ciprian1234/licenta_cnc/docs/poze/asamblare_hardware.jpg

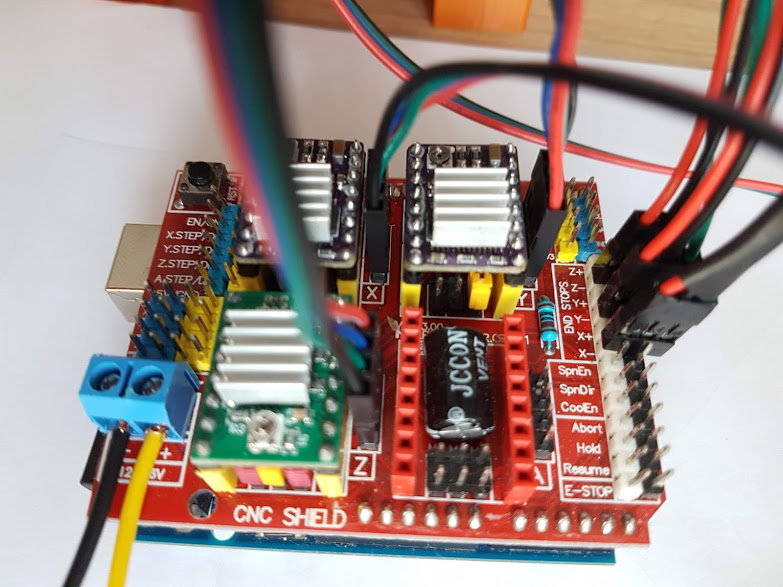
docs/poze/asamblare_hardware.jpg
