ciprian1234/licenta_cnc/docs/poze/printed_parts.PNG

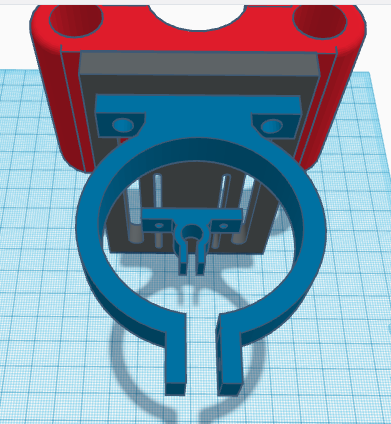
docs/poze/printed_parts.PNG
