ciprian1234/licenta_cnc/docs/template_licenta.docx

# Introducere

Pentru lucrarea de licență mi-am propus să fac o mașină CNC capabilă să deseneze sau să graveze in lemn diferite imagini sau text, prin intermediul unui limbaj standard folosit de CNC-uri sau imprimante 3D numit GCODE.

Aplicația este realizată pentru platforma hardware Arduino. Aceasta primește comenzi GCODE prin intermediul portului USB si le execută rezultant astfel diferite tipuri de mișcări în spațiul cartezian XYZ.

Motivatie.

Am

Pentru că m-am axat mai mult pe partea de software, pentru partea mecanică am folosit o platformă deja existentă pe care am adaptat-o la cerințele mele.

In primul capitol voi vorbi despre componentele necesare.

In cel de-al doilea capitol voi discuta despre asamblarea componentelor.

# 1 Componente necesare

Text descriere.

## 1.1 Hardware

## 1.2 Software

## 1.3 Mecanice

# 2 Asamblare

Text descriere

## 2.1 Subcapitol 1

Text

## 2.2 Subcapitol 2

Text

# 3 Al treilea capitol

Text descriere

## 3.1 Subcapitol 1

Text

## 3.2 Subcapitol 2

Text
