ciprian1234/licenta_cnc/docs/3d_prints/endstop_z_holder.stl

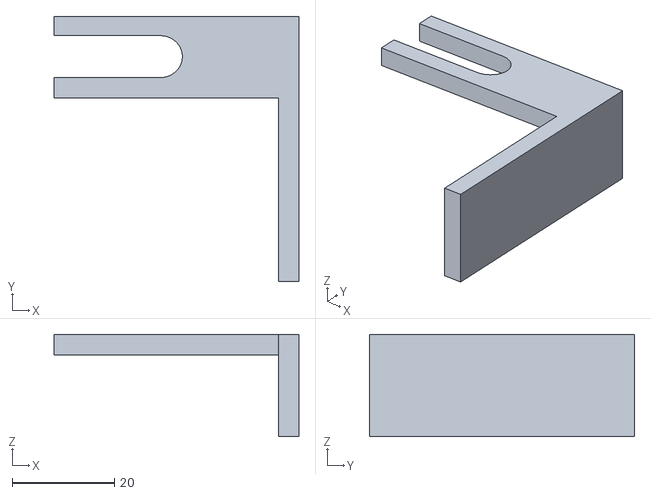
[picture p45: CAD file, 2019-02-08]
docs/3d_prints/endstop_z_holder.stl
48.0 x 52.0 x 20.0
