ciprian1234/licenta_cnc/docs/3d_prints/endstop_x_hit.stl

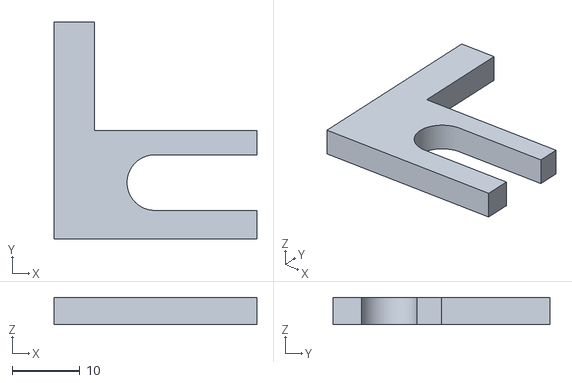
[picture p46: CAD file, 2019-02-08]
docs/3d_prints/endstop_x_hit.stl
30.0 x 32.0 x 4.00
