ciprian1234/licenta_cnc/docs/3d_prints/tool_holder_3.stl

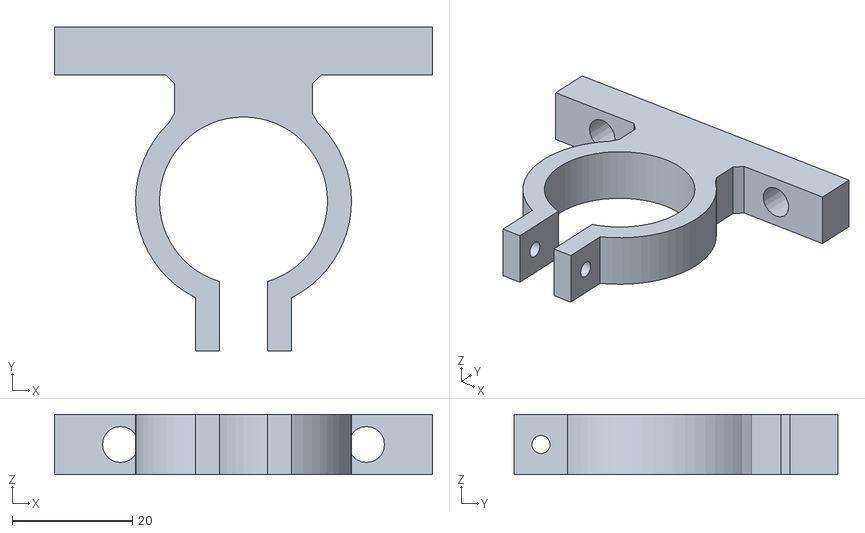
[picture p47: CAD file, 2019-02-08]
docs/3d_prints/tool_holder_3.stl
63.0 x 54.0 x 10.0
