ciprian1234/licenta_cnc/docs/3d_prints/tool_support_1.stl

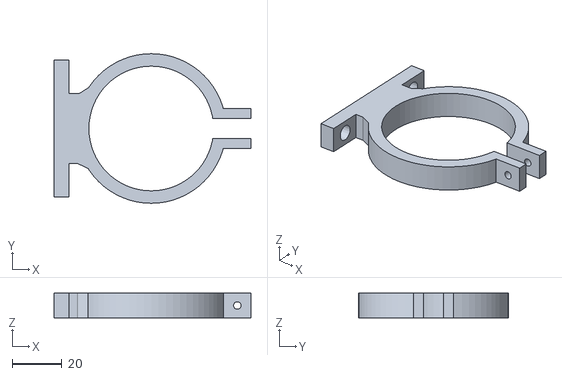
[picture p48: CAD file, 2019-02-08]
docs/3d_prints/tool_support_1.stl
79.0 x 60.0 x 10.0
