ciprian1234/licenta_cnc/docs/3d_prints/tool_adapter.stl

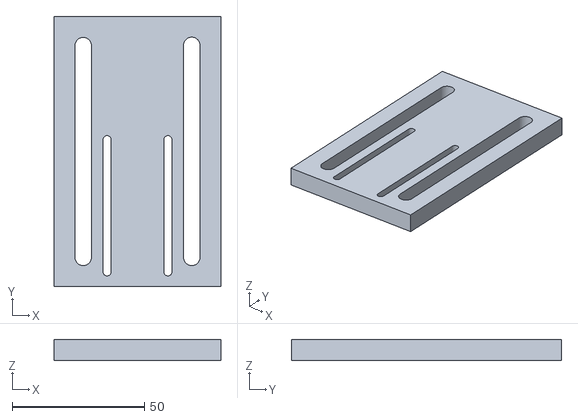
[picture p49: CAD file, 2019-02-08]
docs/3d_prints/tool_adapter.stl
63.0 x 102.0 x 8.00
