ciprian1234/licenta_cnc/docs/3d_prints/tool_holder_2.stl

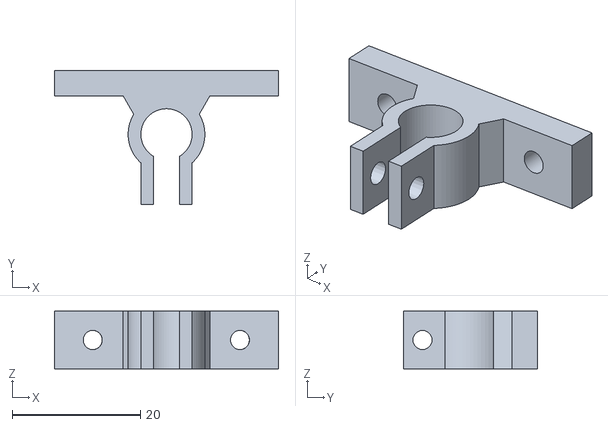
[picture p50: CAD file, 2019-02-08]
docs/3d_prints/tool_holder_2.stl
35.0 x 21.0 x 9.00
