ciprian1234/licenta_cnc/(threads)

Thread 1 (2019-01-14):

Speed of motors issue

ciprian1234, 2019-01-14:
When feed rate (speed) is under 480 mm/min the velocity of the motors is incorrect.

ciprian1234, 2019-01-14:
Fixed issue.

Closed 2019-01-14.
