ciprian1234/licenta_cnc/software/src/motor.cpp

#include "motor.h"
#include "system.h"
#include "config.h"

#define ONE_SENOND_IN_MICROSECONDS  (1000000u)

#define AXIS_MIN_SPEED  (MIN_MOTOR_RPM * AXIS_TRAVEL_DISTANCE_360)
#define AXIS_MAX_SPEED  (MAX_MOTOR_RPM * AXIS_TRAVEL_DISTANCE_360)





Motor::Motor(uint8_t dirPin, uint8_t stepPin, uint8_t endstopPin, uint16_t axisMaxPos):
  DIR_PIN(dirPin), STEP_PIN(stepPin), ENDSTOP_PIN(endstopPin)
{
  // setup motors pins
  pinMode(this->DIR_PIN, OUTPUT);
  pinMode(this->STEP_PIN, OUTPUT);
  pinMode(this->ENDSTOP_PIN, INPUT_PULLUP);

  // set axis limit, current position, and motor speed
  this->AXIS_MAX_STEPS = CONVERT_INTO_STEPS(axisMaxPos);
  this->steps = 0;
  this->setSpeed(500);
}




bool Motor::step(uint8_t direction)
{
  bool endstop = digitalRead(this->ENDSTOP_PIN);
  if((MOTOR_DIRECTION_REVERSE == direction) && (AXIS_ENDSTOP_REACHED == endstop) )
  {
    Serial.println("cnc>>>warning: axis reached reverse ending!"); return false;
  }
  if((MOTOR_DIRECTION_FORWARD == direction) && (this->steps >= this->AXIS_MAX_STEPS) )
  {
    Serial.println("cnc>>>warning: axis reached forward ending!"); return false;
  }
  // Continue if limits were not reached

  // change direction
  digitalWrite(this->DIR_PIN, direction);

  // perform step
  digitalWrite(this->STEP_PIN, LOW);
  this->waitBetweenSteps(ACCELERATION_DISABLED);
  //delay_sync( this->delayBetweenSteps );
  digitalWrite(this->STEP_PIN, HIGH);

  // update position
  if ( direction == MOTOR_DIRECTION_REVERSE)    { this->steps -= 1; }
  else if(direction == MOTOR_DIRECTION_FORWARD) { this->steps += 1; }
  else { /* this is reached only if direction is invalid */ }
  return true;
}



// NOT_USED anymore
// wait some ammount of time between steps to simulate axis moving speed
// input: speed (mm/min)        NUMBER_OF_STEPS_360       AXIS_TRAVEL_DISTANCE_360 = 8mm
// output: wait computed delay between steps
void Motor::waitBetweenSteps(bool accelerationEnabled)
{
  (void)accelerationEnabled; // not implemented anymore
  // acceleration: increment motor RPM every N steps
  // acceleration factor - how much RPM is incremented
  // acceleration_interval - how frequent RPM is incremented


  // SPEED = RPM * AXIS_TRAVEL_DISTANCE_360
  // RPM = SPEED / AXIS_TRAVEL_DISTANCE_360     RPS = RPM / 60
  //float RPS = ((float)this->speed / AXIS_TRAVEL_DISTANCE_360) / 60;  // rotations per second


  // How many steps are required to travel at specified RPM?
  // STEPS_PER_MINUTE = RPM * NUMBER_OF_STEPS_360


  //uint16_t stepsPerSecond = RPS * NUMBER_OF_STEPS_360;

  // What delay between steps is required to travel at specified
  //uint16_t speedDelay = (uint16_t)(ONE_SENOND_IN_MICROSECONDS / stepsPerSecond);

  // STEP_RESOLUTION = AXIS_TRAVEL_DISTANCE_360 / NUMBER_OF_STEPS_360
  // STEPS_PER_MINUTE = SPEED / STEP_RESOLUTION
  // STEPS_PER_SECOND =  (SPEED / STEP_RESOLUTION) / 60
  // delayMicroseconds = 1.000.000 / STEPS_PER_SECOND


  // 300 000us // at 8mm/min,  200 microsteping (0.04mm)
  // 150 000us // at 8mm/min,  200 microsteping (0.02mm)
  //  75 000us // at 8mm/min,  200 microsteping (0.01mm)
  //  37 500us // at 8mm/min,  200 microsteping (0.005mm)
  //  18 750us // at 8mm/min,  200 microsteping (0.0025mm)

  // 1176us // at 2040mm/min,  200 microsteping (0.04mm)
  //  588us // at 2040mm/min,  400 microsteping (0.02mm)
  //  294us // at 2040mm/min,  800 microsteping (0.01mm)
  //  147us // at 2040mm/min, 1600 microsteping (0.005mm)
  //   73us // at 2040mm/min, 3200 microsteping (0.0025mm)
  delay_sync(this->delayBetweenSteps);
}




uint8_t Motor::setSpeed(uint16_t newSpeed)
{
  if( (newSpeed < AXIS_MIN_SPEED) || newSpeed > AXIS_MAX_SPEED ) { return RETURN_SUCCES; /* TODO: set to limits of speed*/ }
  this->speed = newSpeed;

  float RPS = ((float)this->speed / AXIS_TRAVEL_DISTANCE_360) / 60;  // rotations per second
  uint16_t stepsPerSecond = RPS * NUMBER_OF_STEPS_360;

  // What delay between steps is required to travel at specified speed
  this->delayBetweenSteps = (uint16_t)(ONE_SENOND_IN_MICROSECONDS / stepsPerSecond);

  return RETURN_SUCCES;
}



// get motor position in float relative to 0
float Motor::getPosition()
{
  return this->steps * STEP_RESOLUTION;
}



// get motor position in steps relative to 0
int32_t Motor::getPositionInSteps()
{
  return this->steps;
}




// set Logical position to axis
uint8_t Motor::setPosition(float newPosition)
{
  if(CONVERT_INTO_STEPS(newPosition) > this->AXIS_MAX_STEPS) { return ERROR_AXIS_ENDING_EXCEEDED; }
  this->steps = CONVERT_INTO_STEPS(newPosition);
  return RETURN_SUCCES;
}



// move axis to home position
void Motor::moveToHome(void)
{
  // 1. move motor in reverse while endstop is not reached,
  while( AXIS_ENDSTOP_REACHED != digitalRead(this->ENDSTOP_PIN) )
  {
    this->step(MOTOR_DIRECTION_REVERSE);
  }

  // 2. then move motor forward while endstop is pressed
  while( AXIS_ENDSTOP_REACHED == digitalRead(this->ENDSTOP_PIN) )
  {
    this->step(MOTOR_DIRECTION_FORWARD);
  }

  // 3. update logical position of axis to 0
  this->setPosition(0.0);
}
