ciprian1234/licenta_cnc/(commit log)

2018-10-30 Added error handling, reorganized code.
    [config.h, machine.cpp, machine.h, main.cpp, platform_types.h, system.cpp, system.h, utilities.cpp]
2018-10-30 Fixed machine parser issue
    [machine.cpp, main.cpp, utilities.cpp, utilities.h]
2018-10-30 Fix whitespace parser issue
    [machine.cpp, main.cpp, utilities.cpp]
2018-10-31 Added motors implementation stubs
2018-11-01 updated motor files
2018-11-02 added some motor step implementation
2018-11-02 Added motor stepping implementation
2018-11-02 Fixed motor linear movement
    [config.h, machine.cpp, machine.h, motor.cpp, motor.h, system.h]
2018-11-03 changed name of currentCommand into newCmd
2018-11-04 Added some fixes for G01 interpolation
    [machine.cpp, utilities.cpp]
2018-11-04 Fixed float issues related to position incrementation
    [machine.cpp, motor.cpp, motor.h]
2019-01-14 Optimized delay computation between steps, Fixed speed issue, changed connection mechanism.
    [main.cpp, motor.cpp, motor.h]
2019-01-21 Fixed infinite loop bug, started optimisation for G01
    [machine.cpp, motor.cpp, system.cpp, system.h]
2019-01-25 Optimized motor movement code, updated G00 command
2019-01-26 Fixed interpolation issue caused by int32 overflow, which occured when squareing large numbers. Implemented plane selection, increased epsilon value. Increased multistepping to 16x.
    [config.h, machine.cpp, machine.h, main.py, utilities.h]
2019-02-08 Finished documentation and presentation
    [endstop_x_hit.stl, endstop_z_holder.stl, tool_adapter.stl, tool_holder_2.stl, tool_holder_3.stl, tool_support_1.stl]
